sentientthings/Weather_and_Level_Adapter/README.md

# Weather_and_Level_Adapter
Weather and Level Adapter for the Sentient Things IoT Node
