sentientthings/Weather_and_Level_Adapter/pdfs/IoTNodeWeatherandWaterAdapterFeb2019v0.pdf

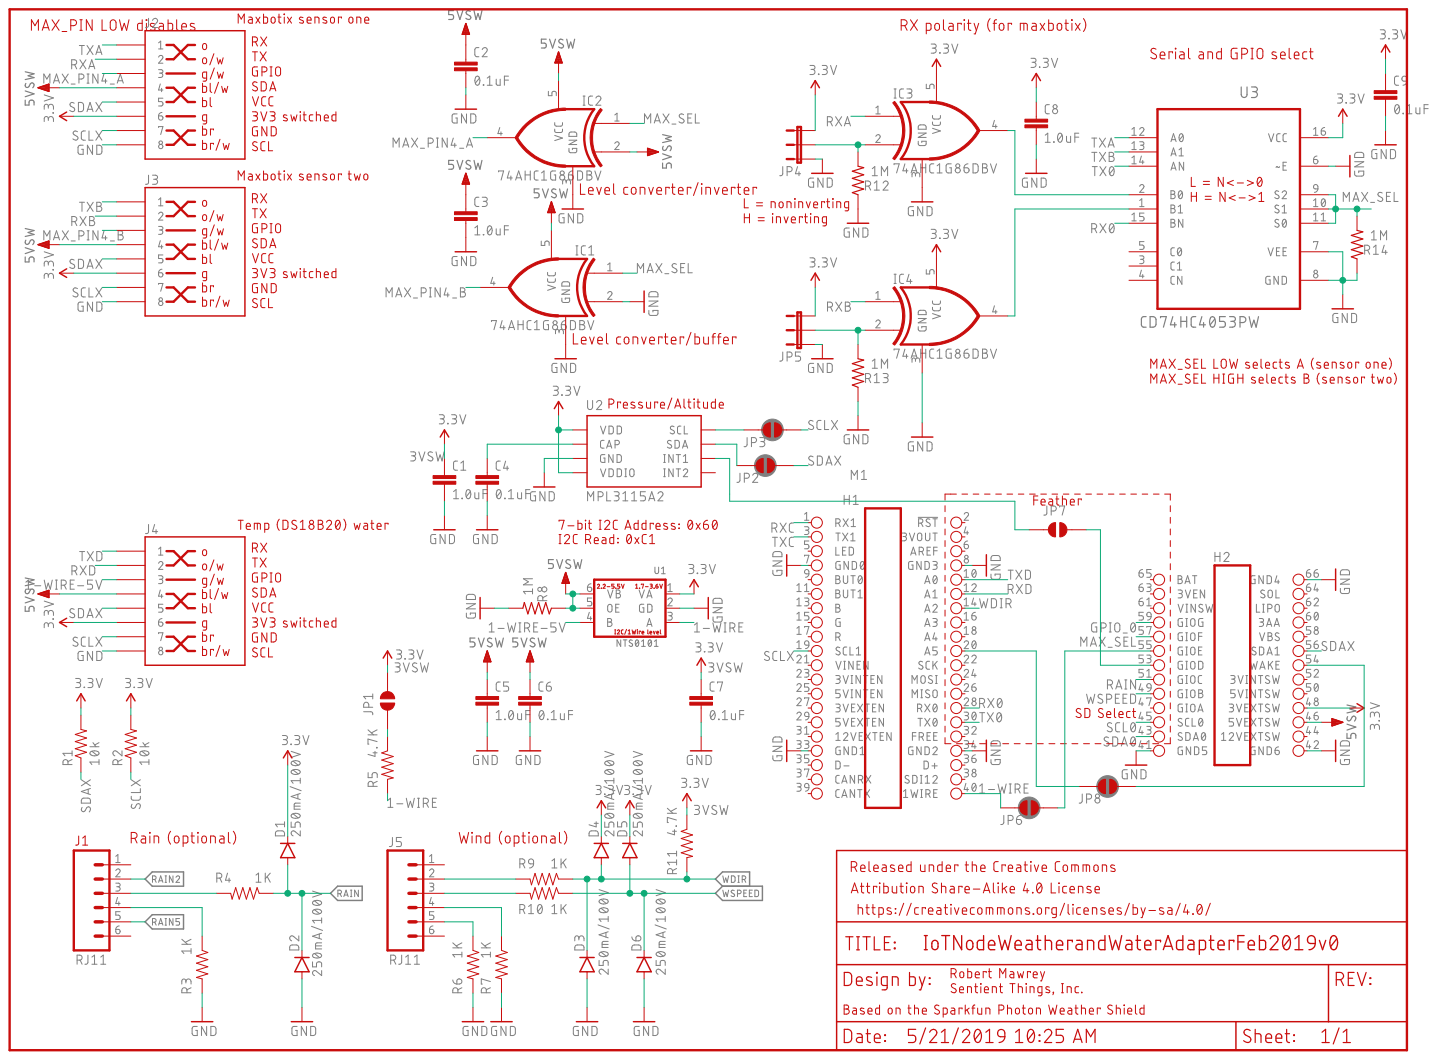
[picture p1: page 1]
