sentientthings/Weather_and_Level_Adapter/eagle/Weather-Level-v0/IoTNodeWeatherandWaterAdapterFeb2019v0.brd

## EAGLE design eagle/Weather-Level-v0/IoTNodeWeatherandWaterAdapterFeb2019v0.brd (2019-05-21)

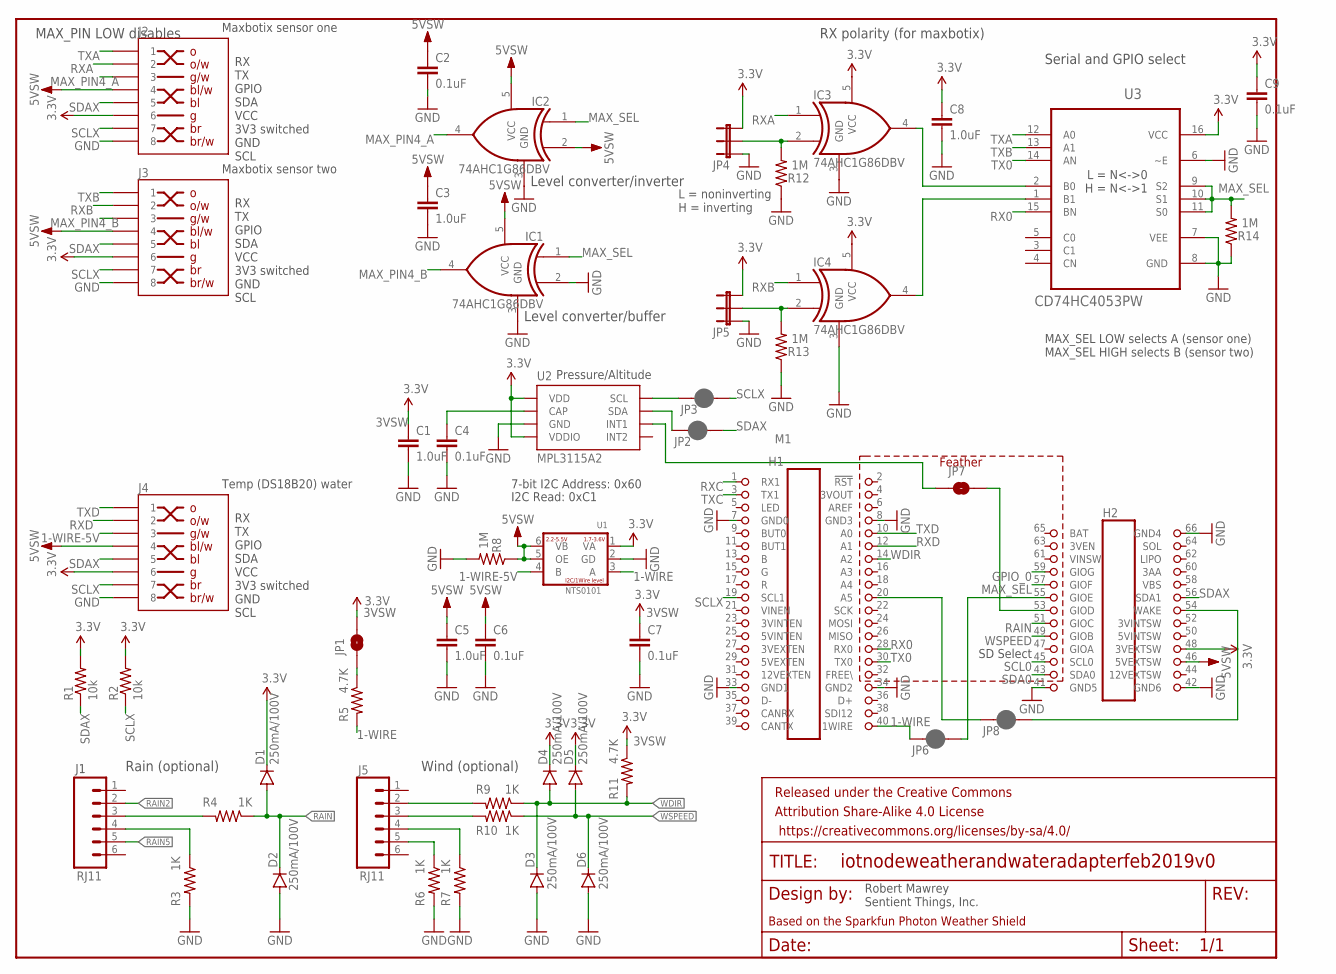
[picture p2: schematic IoTNodeWeatherandWaterAdapterFeb2019v0.sch]

Parts:
C1, C3, C5, C8: 1.0uF; 0603-CAP; PARTNO CC0603KRX7R8BB105
C2, C4, C6, C7, C9: 0.1uF; 0603-CAP; PARTNO C1608X5R1H104K080AA
D1, D2, D3, D4, D5, D6: 250mA/100V; SOD-323; PARTNO BAS16J,135
FRAME1: FRAME-LETTER; CREATIVE_COMMONS; PARTNO DNP
H1: IOTNODE2X20PLACEMENT; 2X20PLACEMENT
H2: IOTNODE2X13PLACEMENT; 2X13PLACEMENT
IC1, IC2, IC3, IC4: 74AHC1G86DBV; SOT23-5; PARTNO SN74AHC1G86DBVR
J1, J5: RJ11; RJ11-6; PARTNO 5555165-1
J2, J3, J4: RJ45-8-UP; RJHSE-5080; PARTNO RJHSE-5080
JP1: JUMPER-PAD-2-NOYES_SILK; PAD-JUMPER-2-NO_YES_SILK; PARTNO DNP
JP2, JP3, JP6, JP8: JUMPER-SMT_2_NC_PASTE_NO-SILK; SMT-JUMPER_2_NC_PASTE_NO-SILK; PARTNO DNP
JP4, JP5: JUMPER-3LOCK; 1X03_LOCK; PARTNO 68000-103HLF
JP7: JUMPER-SMT_2_NO_NO-SILK; SMT-JUMPER_2_NO_NO-SILK; PARTNO DNP
M1: IOTNODEFEATHERWING; PARTNO DNP
R1, R2: 10k; 0603-RES; PARTNO ERJ-3GEYJ103V
R3, R4, R6, R7, R9, R10: 1K; 0603-RES; PARTNO RC0603JR-071KL
R5, R11: 4.7K; 0603-RES; PARTNO RC0603JR-074K7L
R8, R12, R13, R14: 1M; 0603; PARTNO RC0603FR-071ML
U1: NTS0101; SOT363_PHILIPS; PARTNO NTS0101GW,125
U2: MPL3115A2; LGA-8-5X3; PARTNO MPL3115A2
U3: CD74HC4053PW; SOP65P640X120-16N; PARTNO 74HC4053PW,118

Connections:
1-WIRE: JP6.2, M1.40 (1WIRE), R5.2, U1.3 (A)
1-WIRE-5V: J4.3, U1.4 (B)
3VSW: C1.1, C7.1, C8.1, C9.1, D1.C, D4.C, D5.C, IC3.5 (VCC), IC4.5 (VCC), J2.6, J3.6, J4.6, JP1.2, JP4.3, JP5.3, M1.48 (3VEXTSW), R1.2, R2.2, R11.1, U1.1 (VA), U2.1 (VDD), U2.4 (VDDIO), U3.16 (VCC)
5VSW: C2.1, C3.1, C5.1, C6.1, IC1.5 (VCC), IC2.2 (I1), IC2.5 (VCC), J2.4, J3.4, J4.4, M1.46 (5VEXTSW), R8.1, U1.5 (OE), U1.6 (VB)
GND: C1.2, C2.2, C3.2, C4.2, C5.2, C6.2, C7.2, C8.2, C9.2, D2.A, D3.A, D6.A, IC1.2 (I1), IC1.3 (GND), IC2.3 (GND), IC3.3 (GND), IC4.3 (GND), J2.8, J3.8, J4.8, JP4.1, JP5.1, M1.7 (GND0), M1.8 (GND3), M1.33 (GND1), M1.34 (GND2), M1.41 (GND5), M1.42 (GND6), M1.66 (GND4), R3.2, R6.2, R7.2, R8.2, R12.1, R13.1, R14.1, U1.2 (GD), U2.3 (GND), U3.6 (~E), U3.7 (VEE), U3.8 (GND)
GPIO_0: M1.59 (GIOG)
MAX_PIN4_A: IC2.4 (O), J2.3
MAX_PIN4_B: IC1.4 (O), J3.3
MAX_SEL: IC1.1 (I0), IC2.1 (I0), M1.57 (GIOF), R14.2, U3.9 (S2), U3.10 (S1), U3.11 (S0)
unnamed: J5.3, R10.2
unnamed: J5.2, R9.2
unnamed: J1.3, R4.2
unnamed: C4.1, U2.2 (CAP)
unnamed: JP6.1, M1.55 (GIOE)
unnamed: JP7.1, U2.6 (INT1)
unnamed: J1.4, R3.1
unnamed: J5.5, R6.1
unnamed: J5.4, R7.1
unnamed: IC3.4 (O), U3.2 (B0)
unnamed: IC4.4 (O), U3.1 (B1)
unnamed: JP8.2, M1.20 (A5)
unnamed: JP7.2, M1.53 (GIOD)
unnamed: IC4.2 (I1), JP5.2, R13.2
unnamed: JP3.2, U2.8 (SCL)
unnamed: JP8.1, M1.54 (WAKE)
unnamed: JP2.2, U2.7 (SDA)
unnamed: JP1.1, R5.1
RA: IC3.2 (I1), JP4.2, R12.2
RAIN: D1.A, D2.C, M1.51 (GIOC), R4.1
RAIN2: J1.2
RAIN5: J1.5
RX0: M1.28 (RX0), U3.15 (BN)
RXA: IC3.1 (I0), J2.2
RXB: IC4.1 (I0), J3.2
RXC: M1.1 (RX1)
RXD: J4.2, M1.12 (A1)
SCL0: M1.45 (SCL0)
SCLX: J2.7, J3.7, J4.7, JP3.1, M1.19 (SCL1), R2.1
SDA0: M1.43 (SDA0)
SDAX: J2.5, J3.5, J4.5, JP2.1, M1.56 (SDA1), R1.1
TX0: M1.30 (TX0), U3.14 (AN)
TXA: J2.1, U3.12 (A0)
TXB: J3.1, U3.13 (A1)
TXC: M1.3 (TX1)
TXD: J4.1, M1.10 (A0)
WDIR: D3.C, D4.A, M1.14 (A2), R9.1, R11.2
WSPEED: D5.A, D6.C, M1.49 (GIOB), R10.1

Notes on the sheet:
Wind (optional)
Rain (optional)
Based on the Sparkfun Photon Weather Shield
RX polarity (for maxbotix)
Maxbotix sensor one
Maxbotix sensor two
Temp (DS18B20) water
RX TX GPIO SDA VCC 3V3 switched GND SCL
Level converter/buffer
Serial and GPIO select
L = N<->0 H = N<->1
L = noninverting H = inverting
SD Select
I2C Read: 0xC1
7-bit I2C Address: 0x60
Pressure/Altitude
MAX_SEL LOW selects A (sensor one) MAX_SEL HIGH selects B (sensor two)
Level converter/inverter
MAX_PIN LOW disables
Robert Mawrey Sentient Things, Inc.

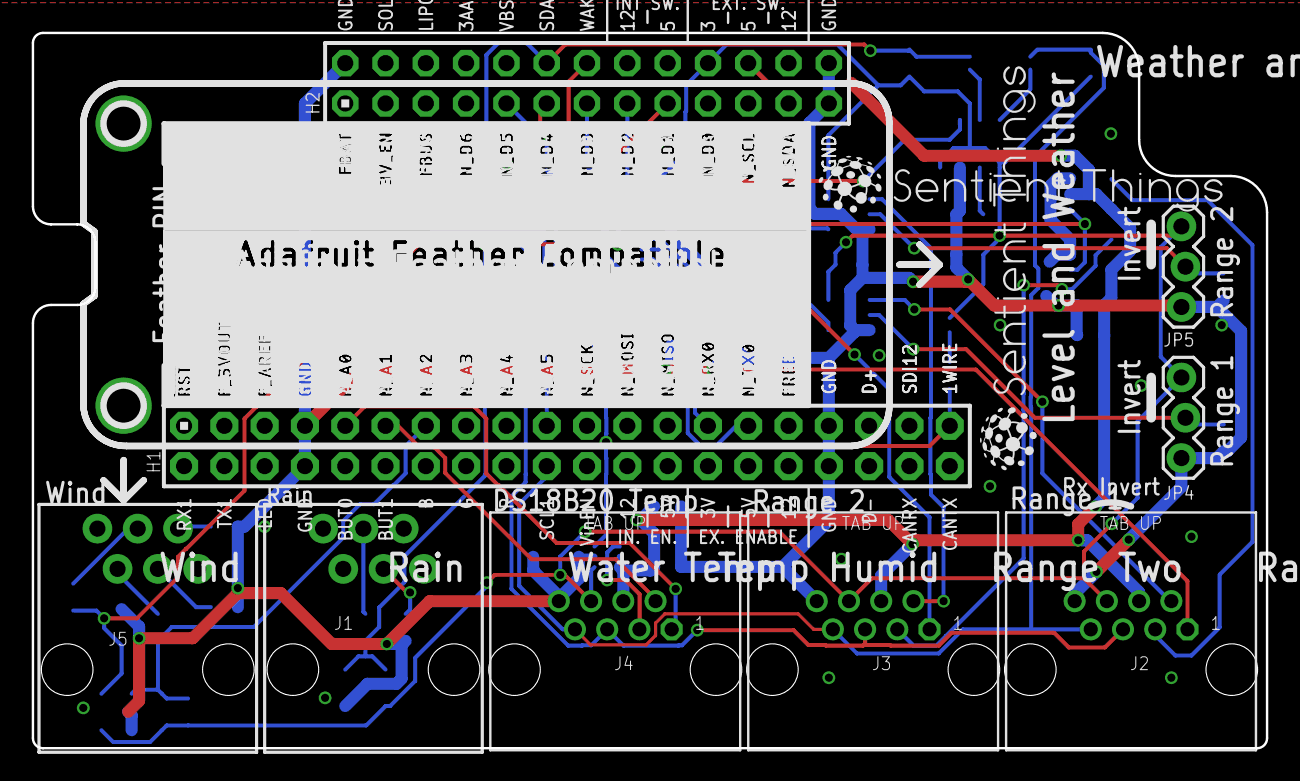
[picture p3: board IoTNodeWeatherandWaterAdapterFeb2019v0.brd from above]

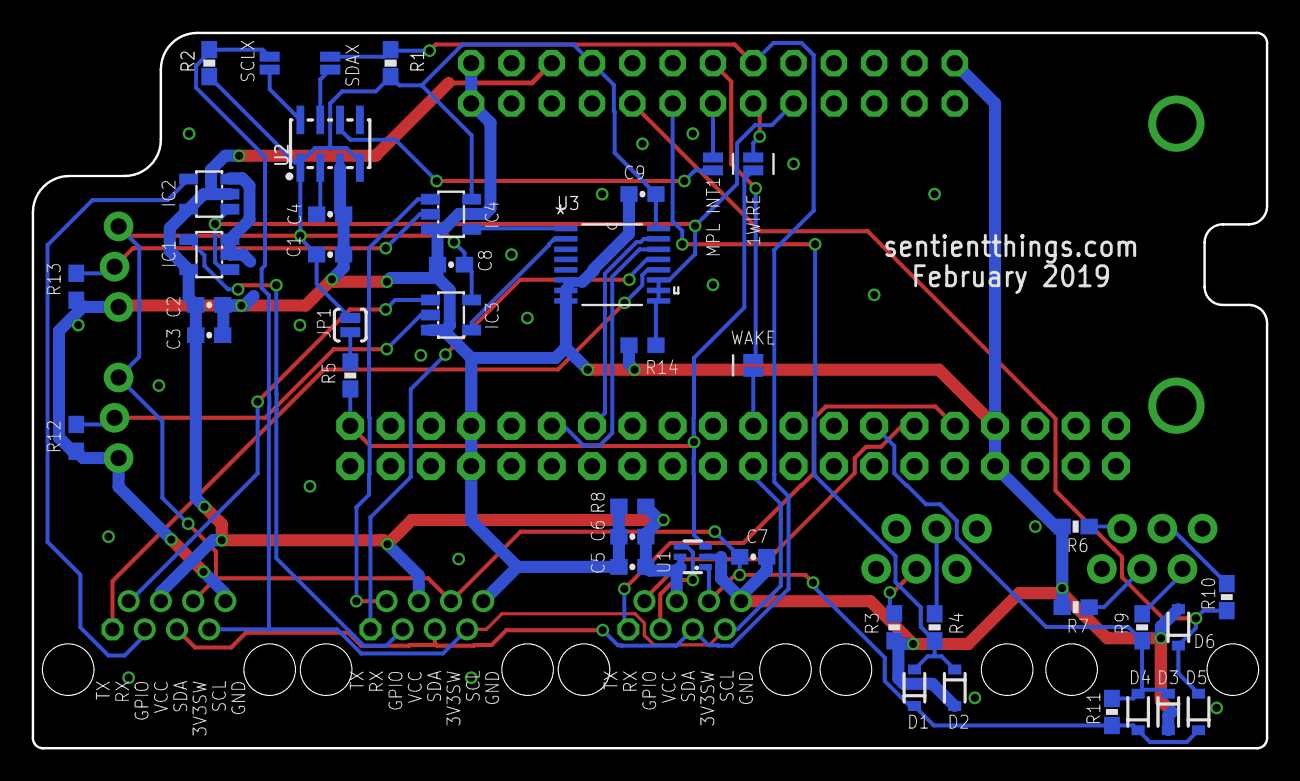
[picture p4: board IoTNodeWeatherandWaterAdapterFeb2019v0.brd from below]

Board: 2 copper layers, 77.8 x 45.1 mm, 56 parts (42 on the bottom side), 40 nets.

Other parts of the board:
U$1: SENTIENT_TSILK
U$2: SENTIENT_THINGS
U$3: IOTNODEINSIDESILK
