sentientthings/Weather_and_Level_Adapter/(notices)

Notices in the files:
parts and their libraries:
SparkFun-Connectors: Licensing: Creative Commons ShareAlike 4.0 International - https://creativecommons.org/licenses/by-sa/4.0
Mawrey: Released under the Creative Commons Attribution Share-Alike 4.0 License
Mawrey: https://creativecommons.org/licenses/by-sa/4.0
